happymacer/PF906-treadmill-motor-controller-/pf906 dc motor driver board V3a Dec 22.pdf

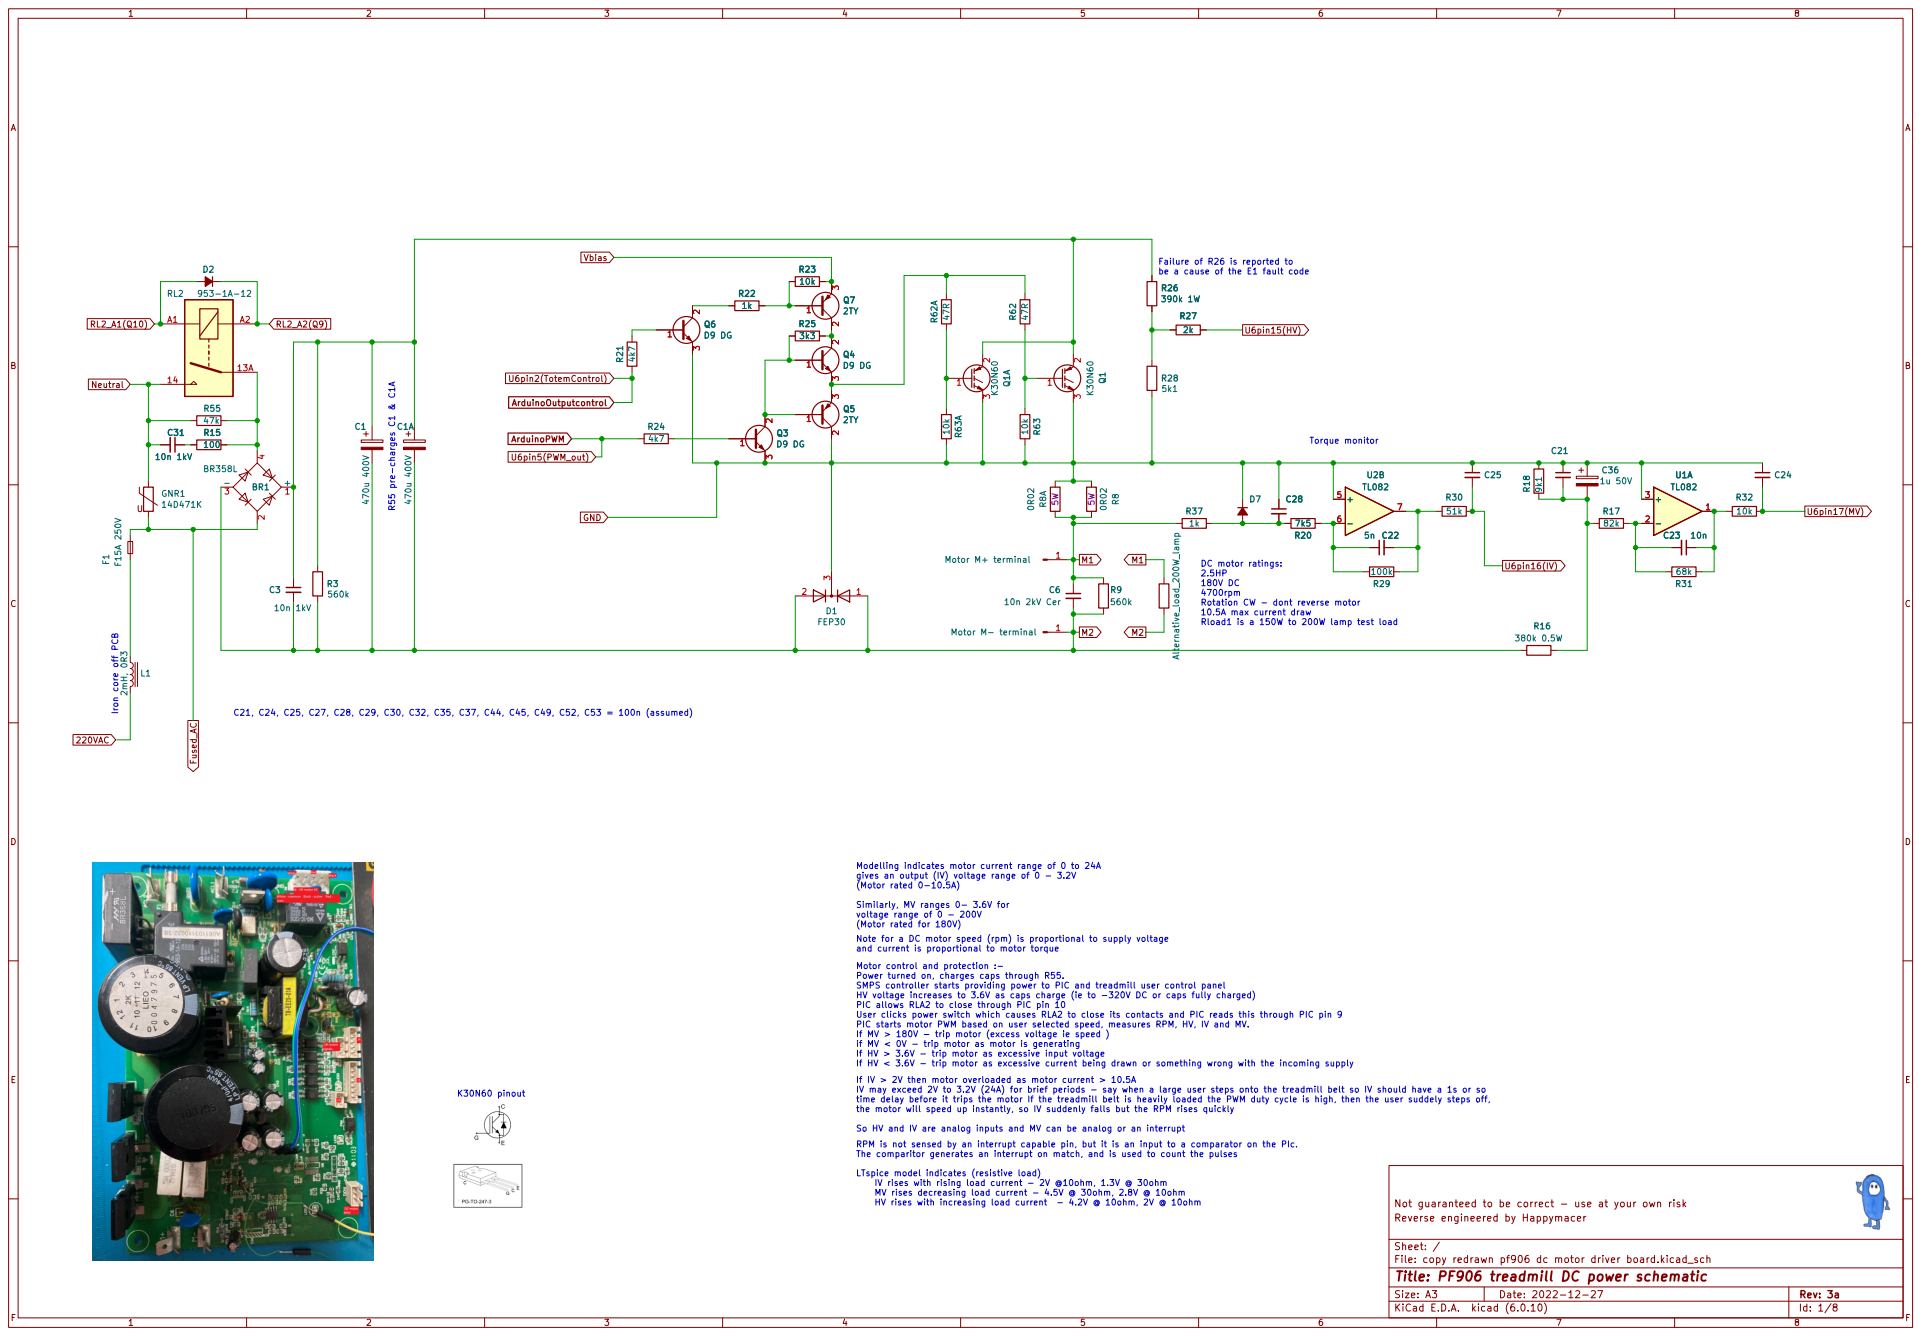
[picture p1: page 1]

If HV < 3.6V - trip motor as excessive current being drawn or something wrong with the incoming supply R55 pre-charges C1 & C1A Iron core off PCB

4700rpm
Rotation CW - dont reverse motor 10.5A max current draw Rload1 is a 150W to 200W lamp test load

Modelling indicates motor current range of 0 to 24A
gives an output (IV) voltage range of 0 - 3.2V
(Motor rated 0-10.5A)

Similarly, MV ranges 0- 3.6V for
voltage range of 0 - 200V
(Motor rated for 180V)
Note for a DC motor speed (rpm) is proportional to supply voltage
and current is proportional to motor torque
Motor control and protection :-
Power turned on, charges caps through R55.
SMPS controller starts providing power to PIC and treadmill user control panel
HV voltage increases to 3.6V as caps charge (ie to -320V DC or caps fully charged)
PIC allows RLA2 to close through PIC pin 10
User clicks power switch which causes RLA2 to close its contacts and PIC reads this through PIC pin 9
PIC starts motor PWM based on user selected speed, measures RPM, HV, IV and MV.
If MV > 180V - trip motor (excess voltage ie speed )
if MV < 0V - trip motor as motor is generating
If HV > 3.6V - trip motor as excessive input voltage

If IV > 2V then motor overloaded as motor current > 10.5A
IV may exceed 2V to 3.2V (24A) for brief periods - say when a large user steps onto the treadmill belt so IV should have a 1s or so
time delay before it trips the motor If the treadmill belt is heavily loaded the PWM duty cycle is high, then the user suddely steps off,
the motor will speed up instantly, so IV suddenly falls but the RPM rises quickly

So HV and IV are analog inputs and MV can be analog or an interrupt
RPM is not sensed by an interrupt capable pin, but it is an input to a comparator on the PIc.
The comparitor generates an interrupt on match, and is used to count the pulses

LTspice model indicates (resistive load)
IV rises with rising load current - 2V @10ohm, 1.3V @ 30ohm
MV rises decreasing load current - 4.5V @ 30ohm, 2.8V @ 10ohm
HV rises with increasing load current - 4.2V @ 10ohm, 2V @ 10ohm

Not guaranteed to be correct - use at your own risk
File: copy redrawn pf906 dc motor driver board.kicad_sch Sheet: / Reverse engineered by Happymacer

Id: 1/8 Title: PF906 treadmill DC power schematic

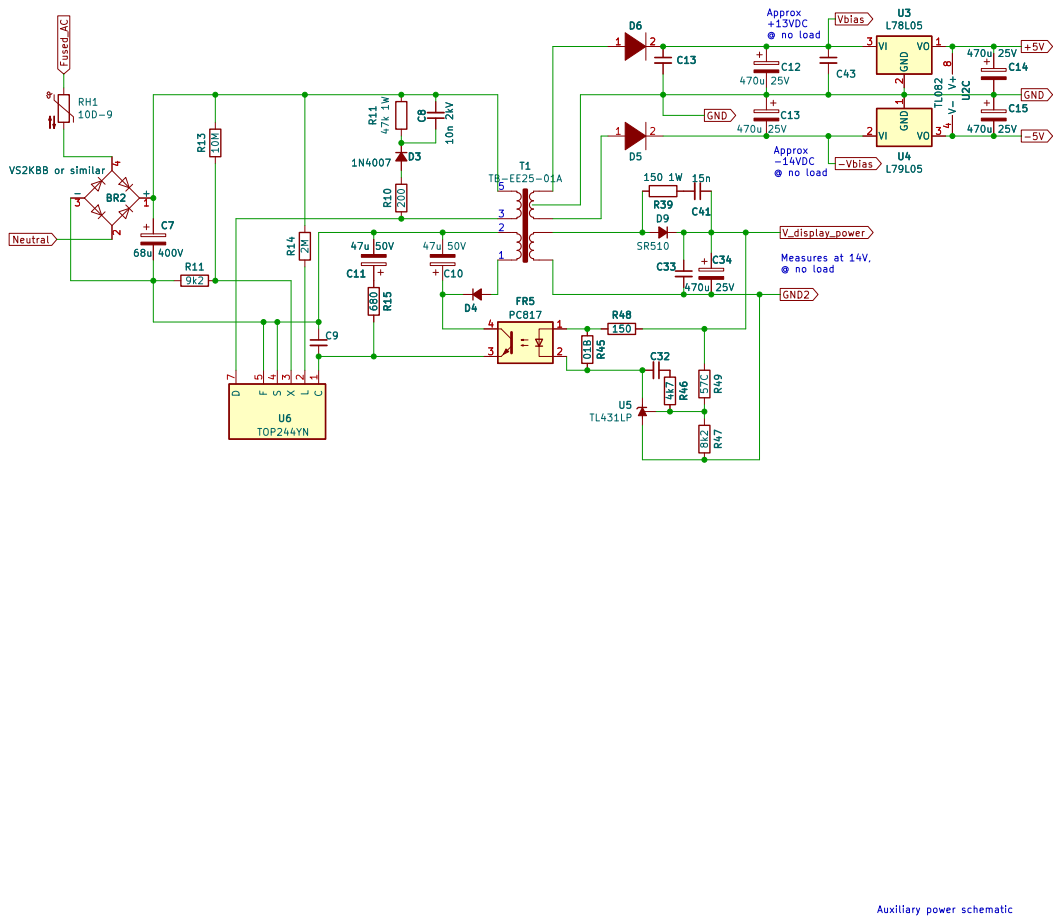
[picture p2: page 2]

Not guaranteed to be correct - use at your own risk
Reverse engineered by Happymacer

Sheet: /2 Aux power/
File: Aux power.kicad_sch
Id: 2/8 Title: PF906 treadmill DC power schematic

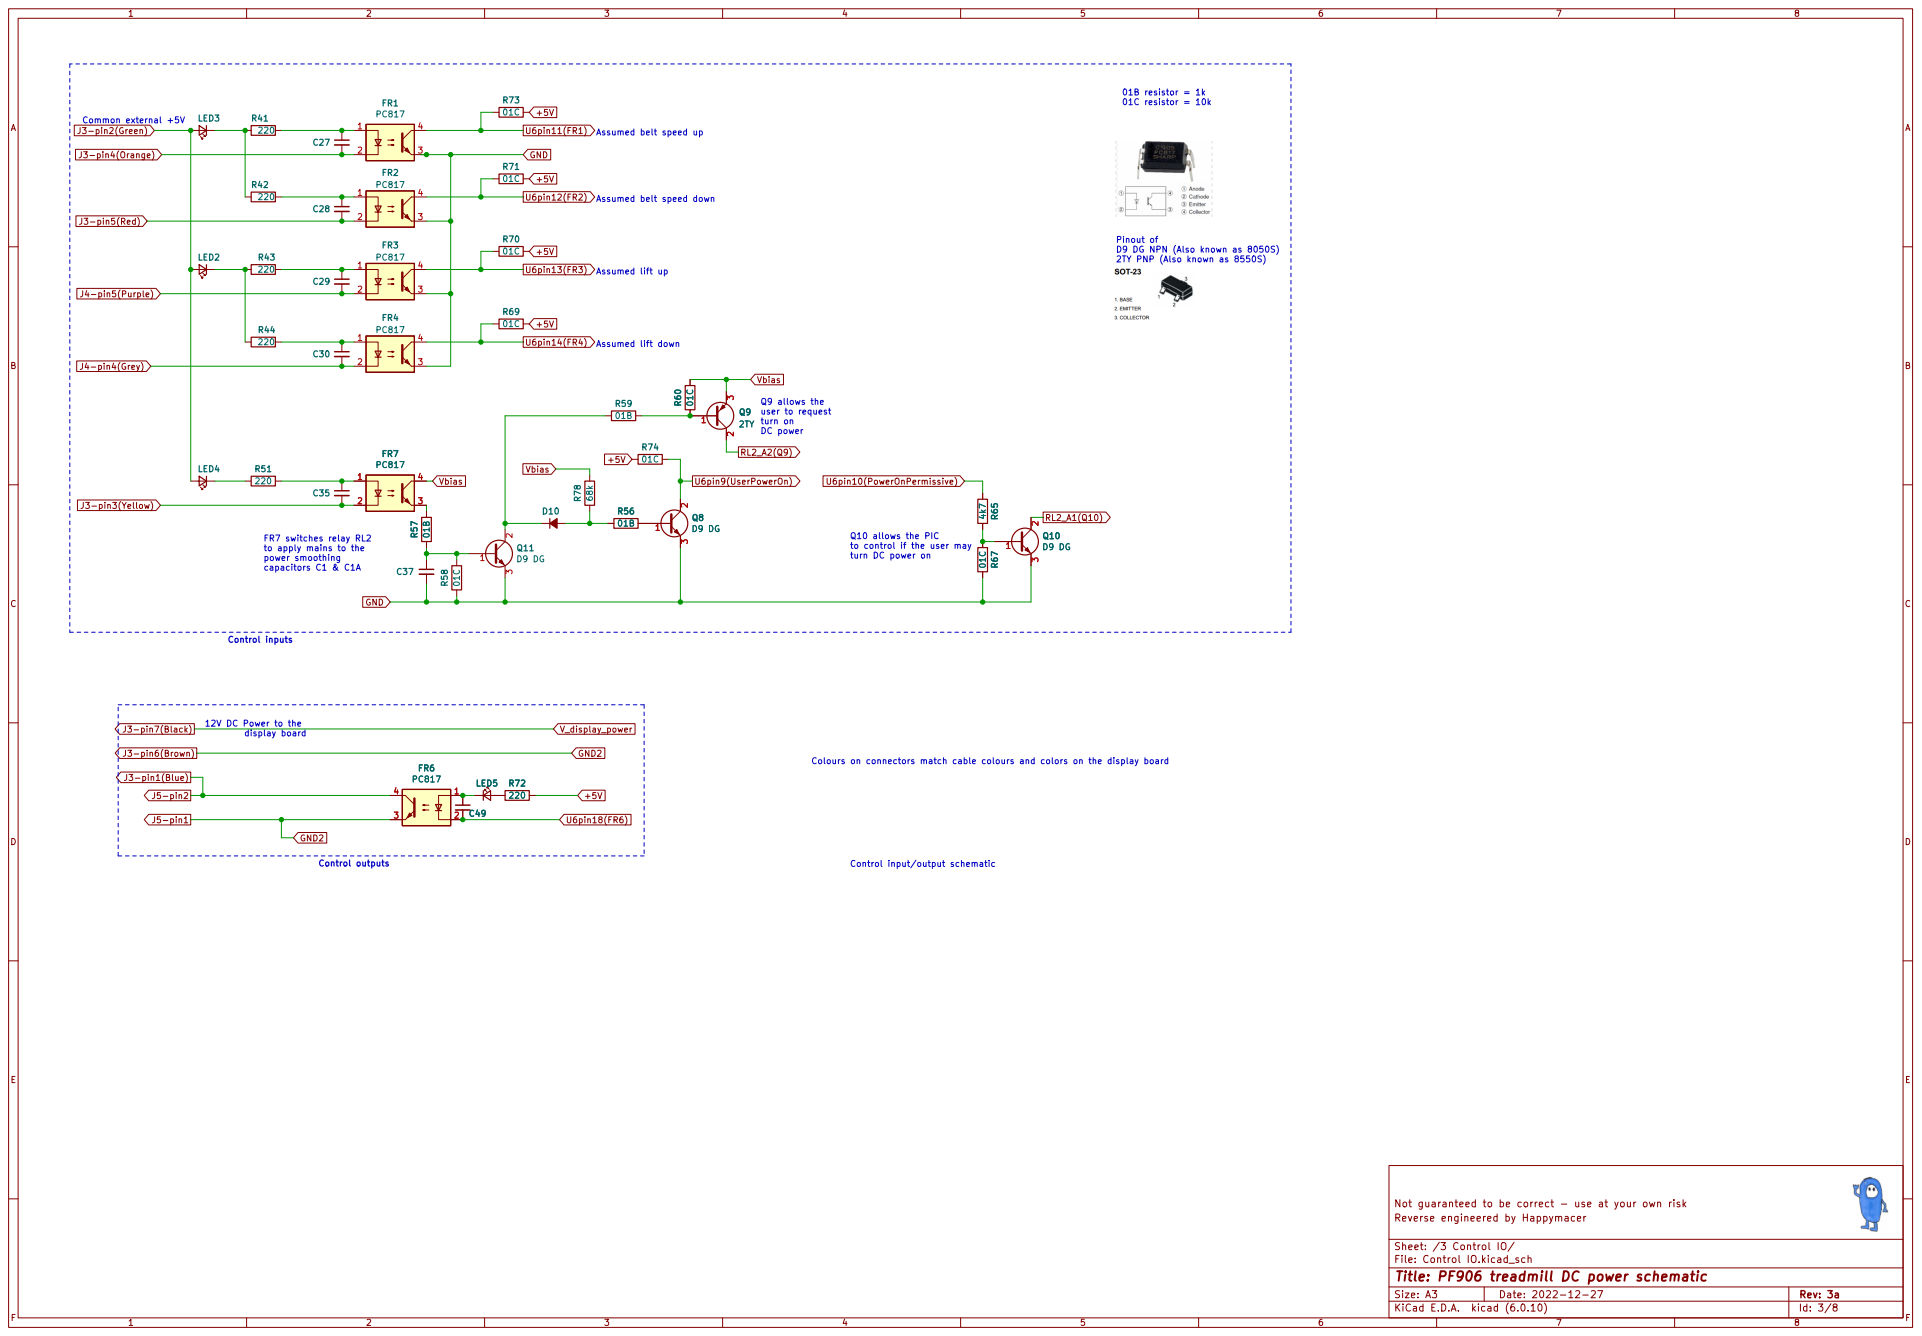
[picture p3: page 3]

01B resistor = 1k 01C resistor = 10k Pinout of D9 DG NPN (Also known as 8050S)

turn on DC power Common external +5V
J3-pin2(Green)

Assumed belt speed down

2TY PNP (Also known as 8550S) Q10 allows the PIC

Assumed lift down Control inputs

FR7 switches relay RL2
to apply mains to the
power smoothing
capacitors C1 & C1A

to control if the user may
turn DC power on

12V DC Power to the display board

Colours on connectors match cable colours and colors on the display board

Control input/output schematic

Not guaranteed to be correct - use at your own risk
File: Control IO.kicad_sch Sheet: /3 Control IO/ Reverse engineered by Happymacer

Id: 3/8 Title: PF906 treadmill DC power schematic

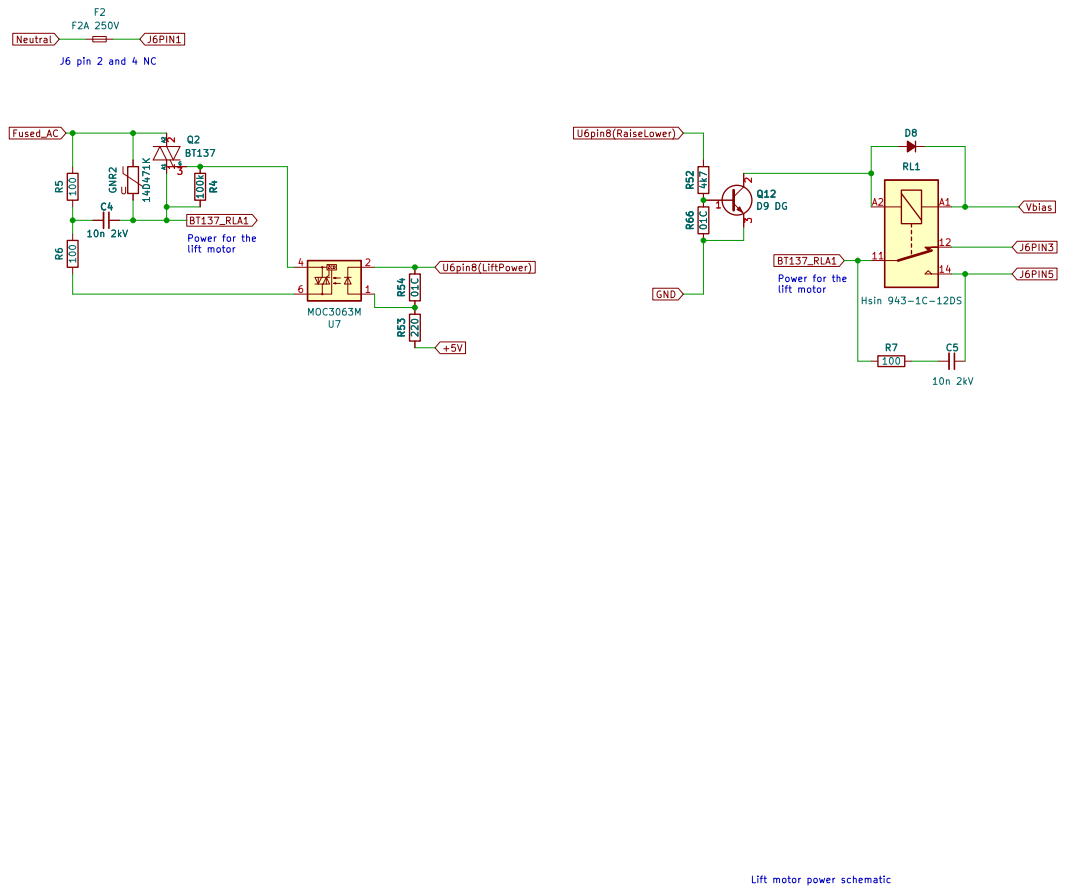
[picture p4: page 4]

Lift motor power schematic

Not guaranteed to be correct - use at your own risk
File: Lift Motor Control.kicad_sch Sheet: /4 Lift Motor Control/ Reverse engineered by Happymacer

Id: 4/8 Title: PF906 treadmill DC power schematic

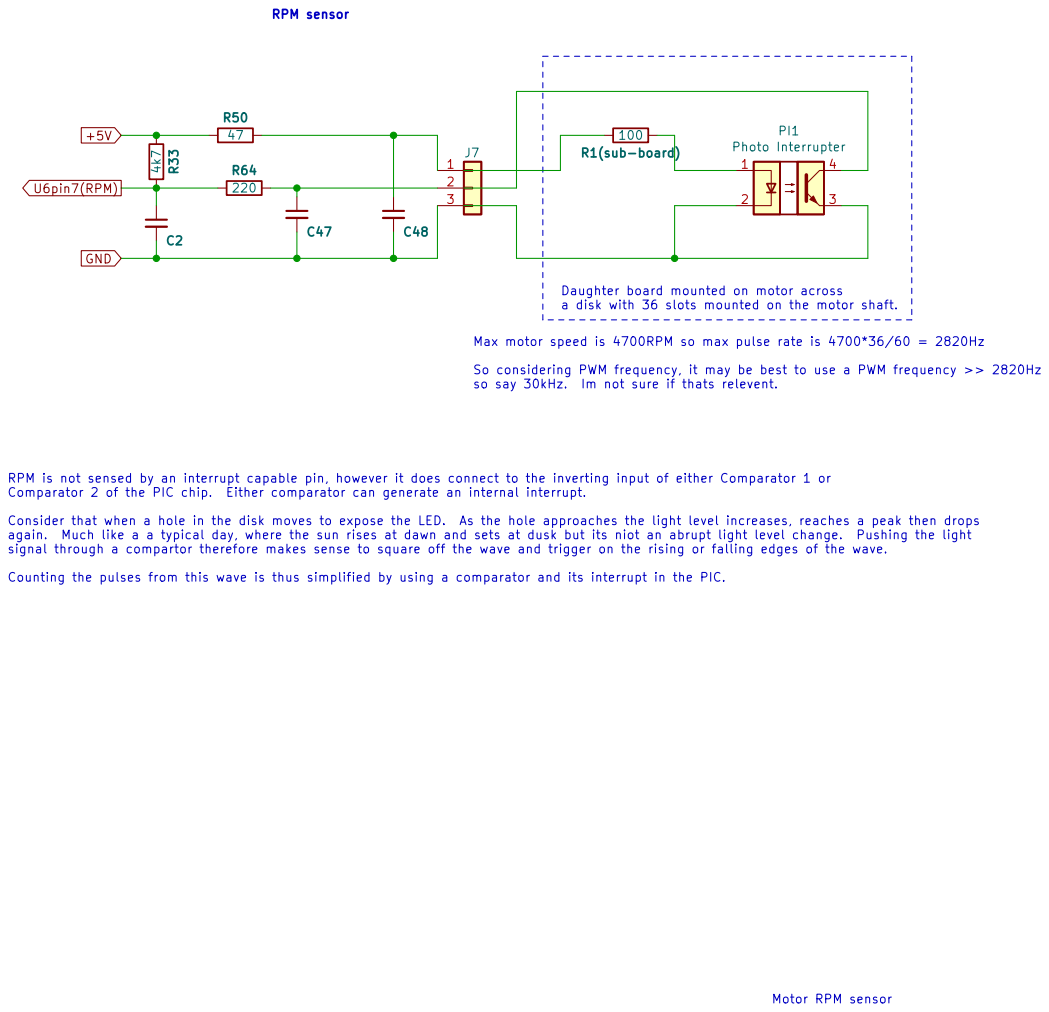
[picture p5: page 5]

So considering PWM frequency, it may be best to use a PWM frequency >> 2820Hz

Comparator 2 of the PIC chip. Either comparator can generate an internal interrupt.

Consider that when a hole in the disk moves to expose the LED. As the hole approaches the light level increases, reaches a peak then drops
again. Much like a a typical day, where the sun rises at dawn and sets at dusk but its niot an abrupt light level change. Pushing the light
signal through a compartor therefore makes sense to square off the wave and trigger on the rising or falling edges of the wave.

Counting the pulses from this wave is thus simplified by using a comparator and its interrupt in the PIC.

File: RPM.kicad_sch Sheet: /5 RPM / Reverse engineered by Happymacer

Id: 5/8 Title: PF906 treadmill DC power schematic

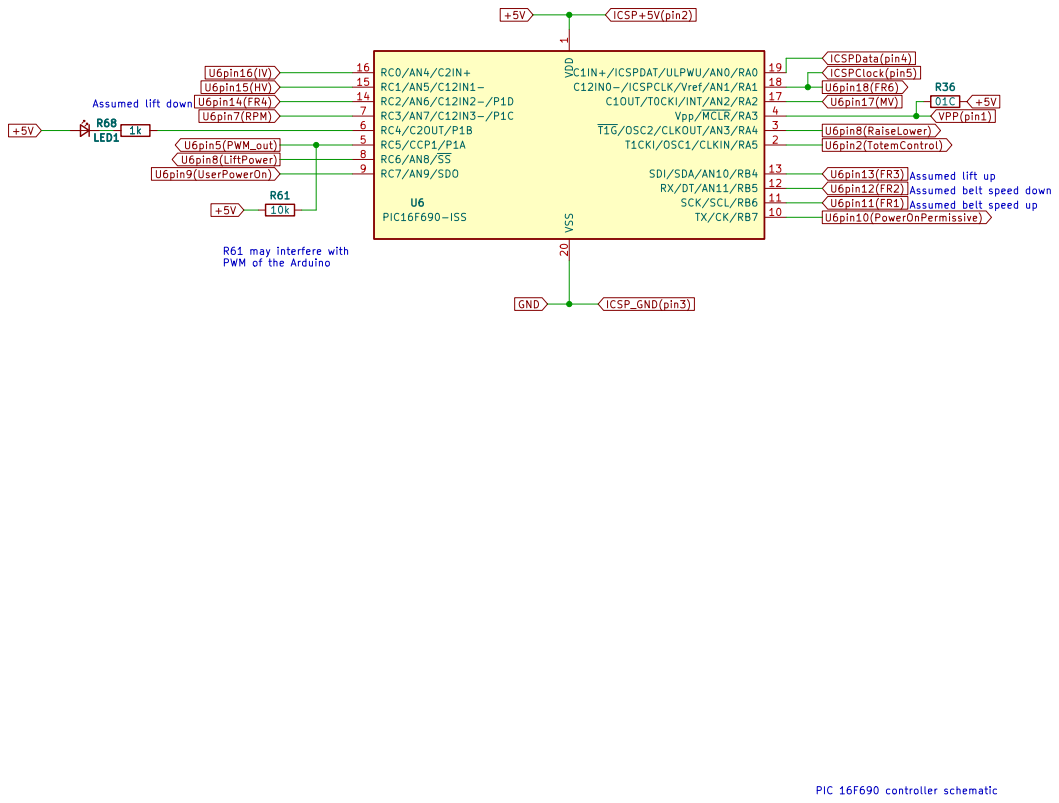
[picture p6: page 6]

Assumed belt speed up PIC 16F690 controller schematic

1 TX/CK/RB7 10 SCK/SCL/RB6 11 RX/DT/AN11/RB5 12 SDI/SDA/AN10/RB4 13 RC2/AN6/C12IN2-/P1D 14 RC1/AN5/C12IN1- 15 RC0/AN4/C2IN+ 16 C1OUT/T0CKI/INT/AN2/RA2 17 C12IN0-/ICSPCLK/Vref/AN1/RA1 18 C1IN+/ICSPDAT/ULPWU/AN0/RA0 19 T1CKI/OSC1/CLKIN/RA5 2 VSS 20

Assumed belt speed down LED1 R68

Not guaranteed to be correct - use at your own risk
File: PIC 16F690 Controller.kicad_sch Sheet: /6 PIC 16F690 Controller/ Reverse engineered by Happymacer

Id: 6/8 Title: PF906 treadmill DC power schematic

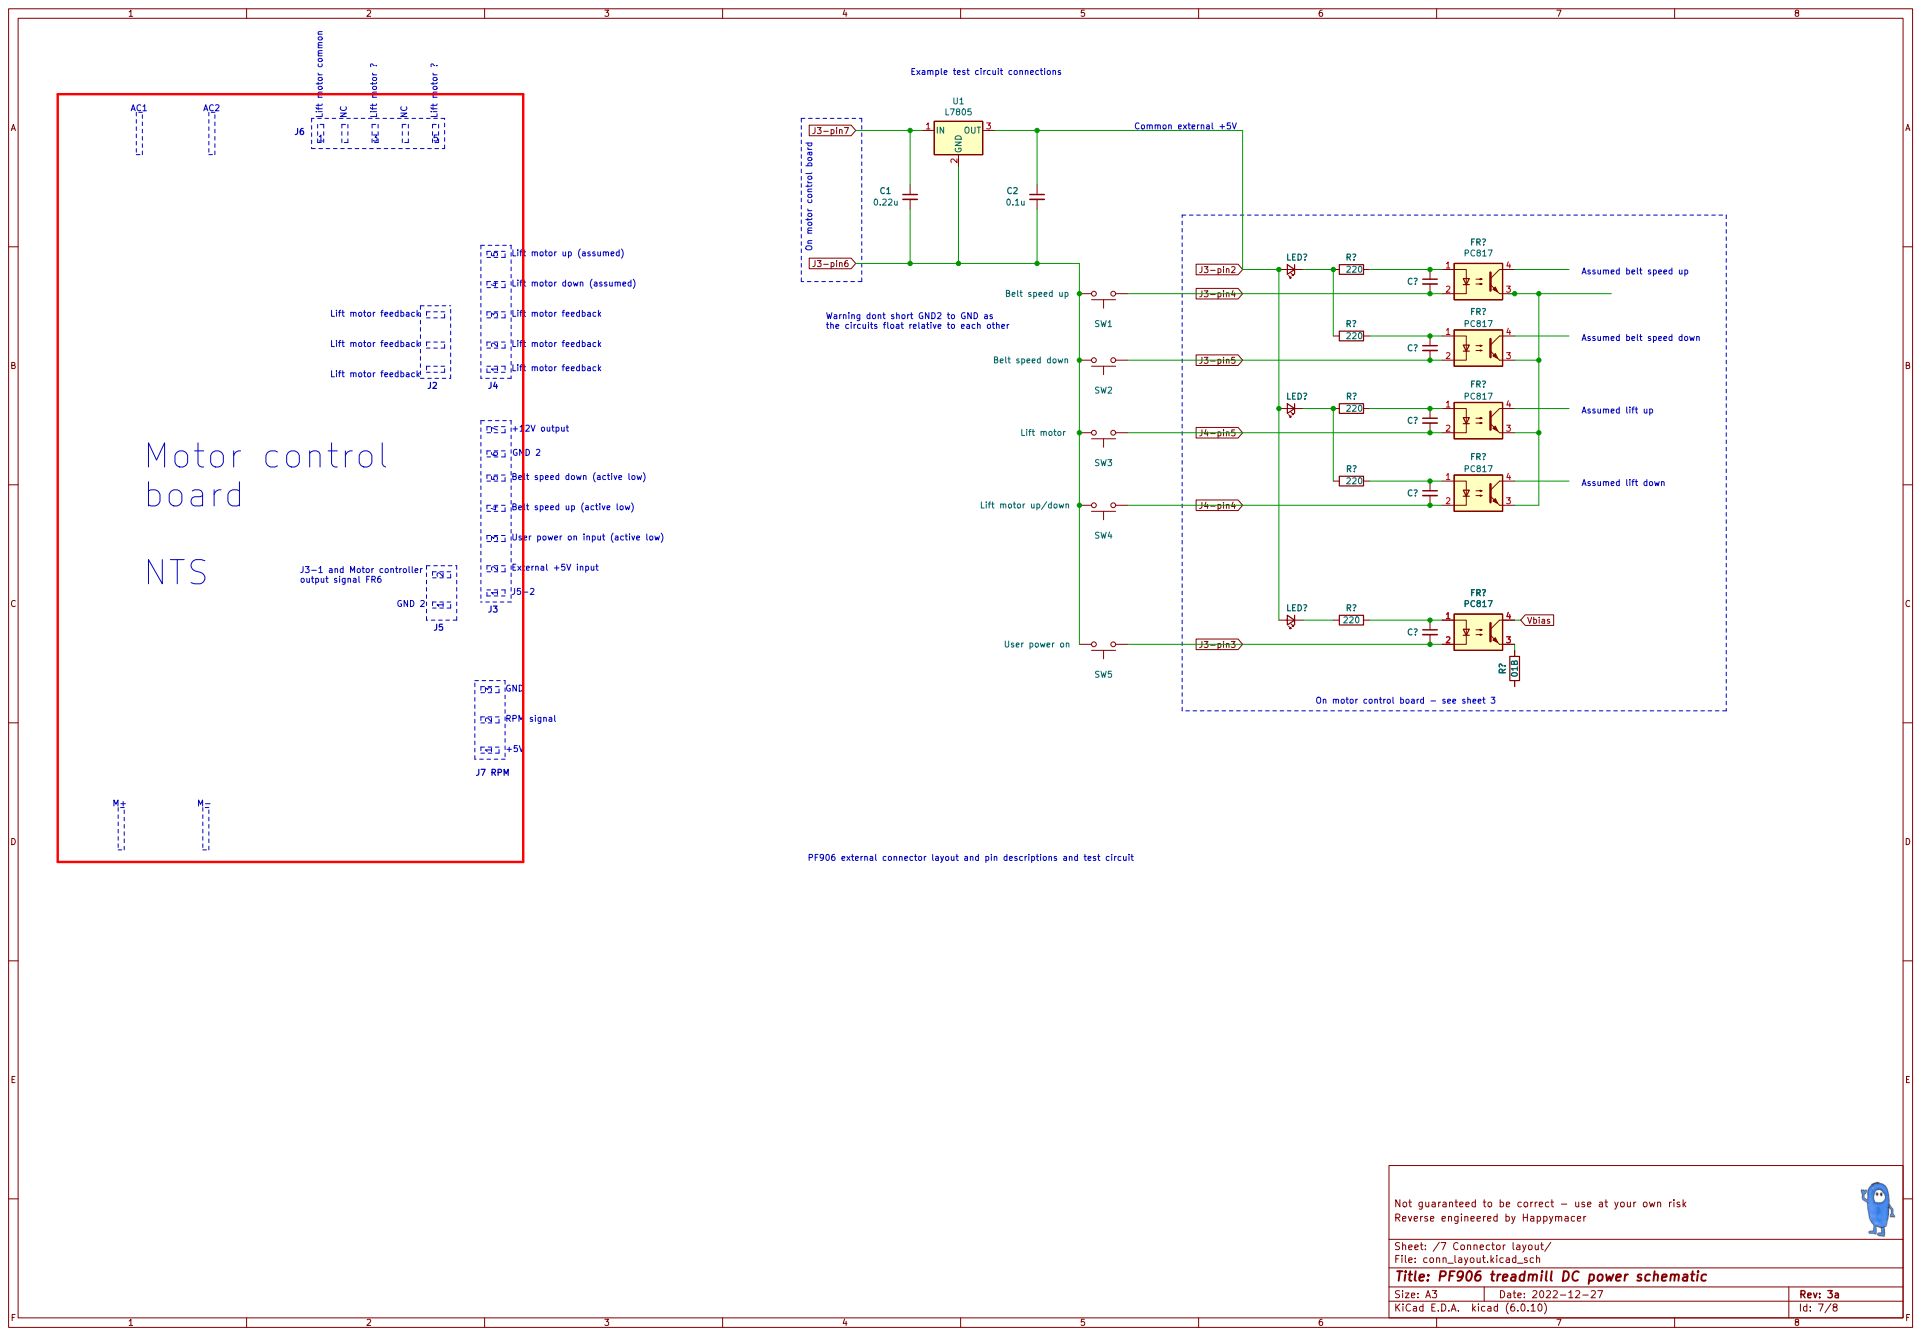
[picture p7: page 7]

Assumed lift up NC

Lift motor up (assumed) 3

Assumed belt speed up

Lift motor feedback Lift motor feedback Lift motor down (assumed)

Lift motor feedback

2 Warning dont short GND2 to GND as

Assumed belt speed down

Lift motor feedback Motor control

Belt speed down (active low) 1

Belt speed up (active low)

Lift motor up/down

User power on input (active low)

J3-1 and Motor controller output signal FR6

Not guaranteed to be correct - use at your own risk
Reverse engineered by Happymacer

Sheet: /7 Connector layout/
File: conn_layout.kicad_sch
Id: 7/8 Title: PF906 treadmill DC power schematic

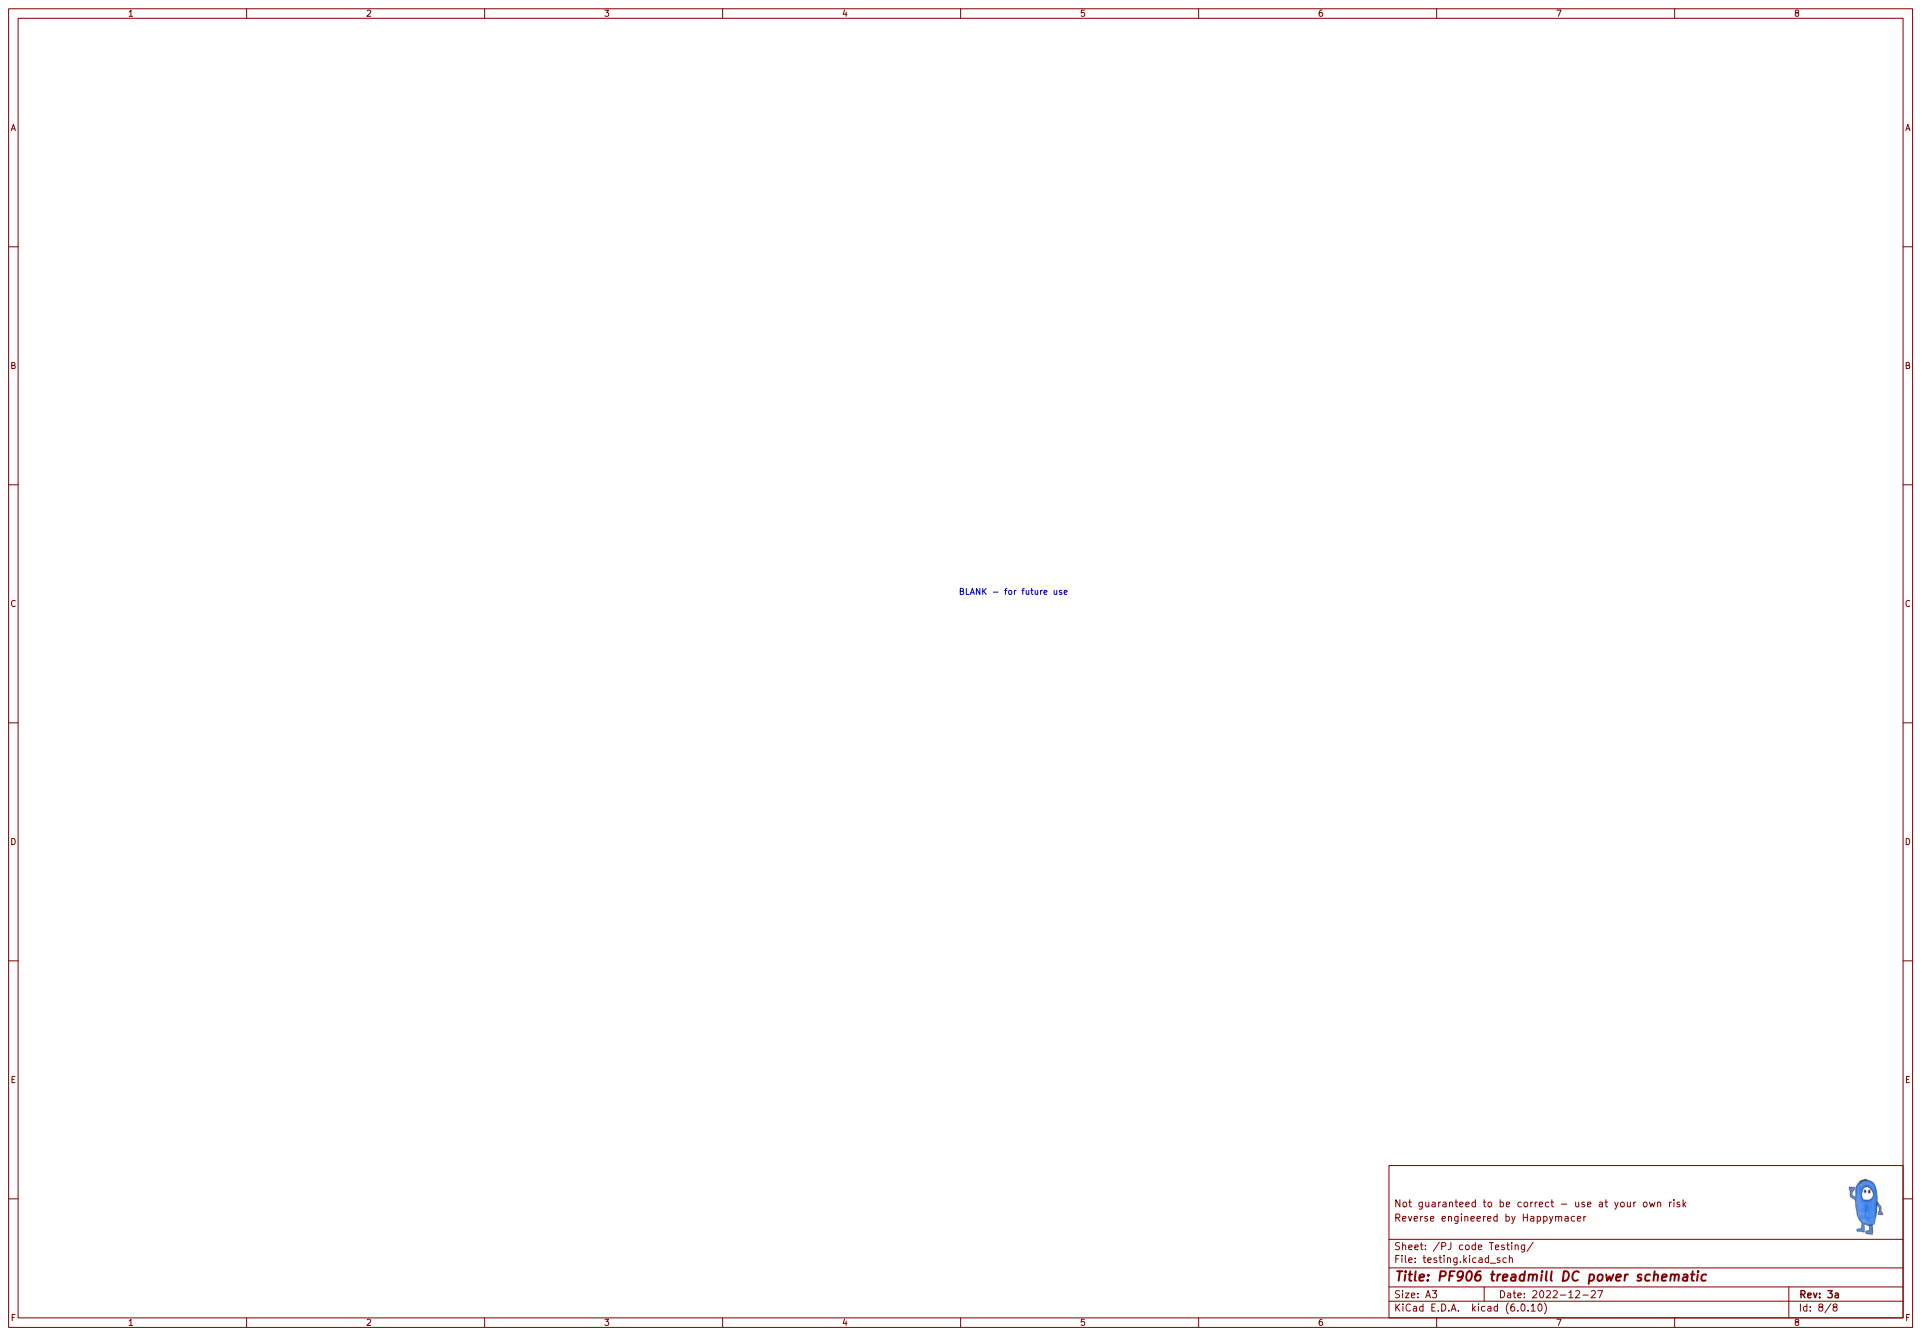
[picture p8: page 8]

BLANK - for future use

Not guaranteed to be correct - use at your own risk
Reverse engineered by Happymacer

Sheet: /PJ code Testing/
File: testing.kicad_sch
Id: 8/8 Title: PF906 treadmill DC power schematic
