happymacer/PF906-treadmill-motor-controller-/Arduino pro-mini pf906 PWM controller.pdf

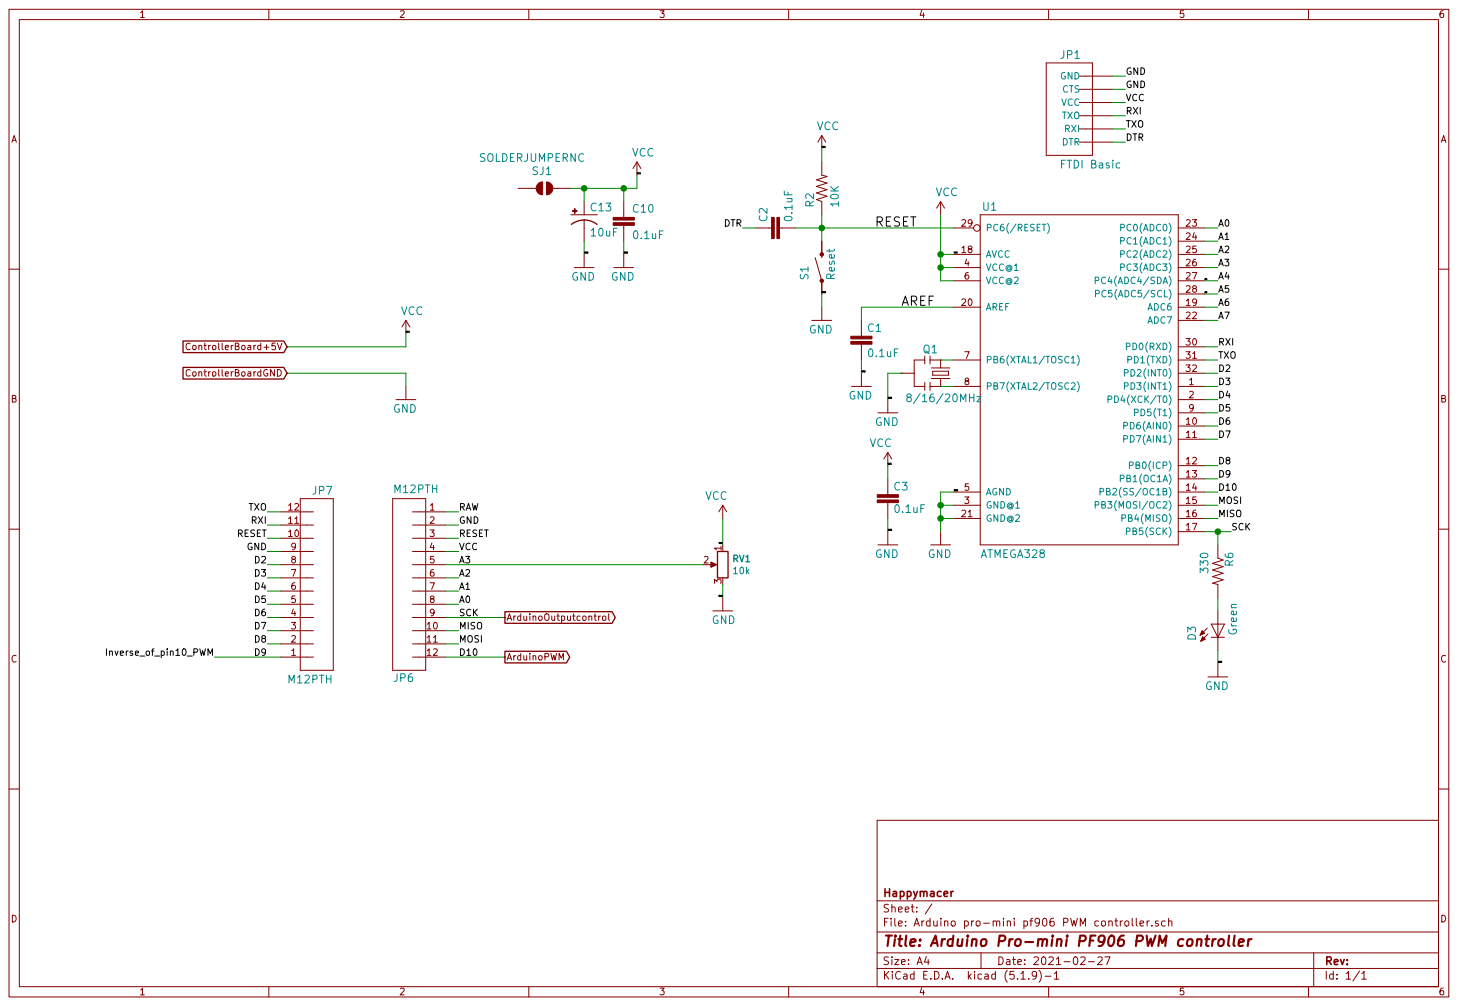
[picture p9: page 1]

Id: 1/1 Title: Arduino Pro-mini PF906 PWM controller
