happymacer/PF906-treadmill-motor-controller-/(threads)

Thread 1 (2022-12-23):

Minor correction of original schematics.

henri62, 2022-12-23:
FYI: (since the original kicad schematic is not published I cannot modify it myself)

Please adjust the schematic:
R26 =390k (and is often the cause of a defect with code E1)
C6 is a non-polar ceramic capactor of 10 n/ 1kV.
R9 = 560 k

J3-pin1 is also connected to J5-pin2, add a label at the left bottom somewhere too.

happymacer, 2022-12-27:
Thanks for the input Henri62.  I have corrected the schematic as follows:
R26 updated to 390k
C6 on my board is 2kV, and as its the "conservative" alternative Ive left it as is.  Added Ceramic and changed symbol to non polarised
R9 is already set at 560k - not sure what you meant.
J3-1 link to J5-2 is already shown on sheet 7 so not added to sheet 1.

I will upload the new schematic file shortly.

henri62, 2022-12-28:
Both R9 and C6 had no value in the schematic. But I see now that the schematic is completely updated into multiple pages and much more detailed.
The schematic I saw (and where the comment was based on) was only 1 page. That is where the confusion comes from.
This issue can be closed.

happymacer, 2022-12-30:
ta, no worries!

Closed 2022-12-30.

Thread 2 (2024-10-16):

Relay part number

kambadur, 2024-10-16:
Appreciate the good work. Have you identified the ac supply side relay part number? If so could you please sahre it.
If not, do you know any same form factor relay for replacement?
Thank you and kind regards,
Sam

happymacer, 2024-10-18:
Thanks Kambadur! Nice to hear!  The supply side relay is a HSINDA953-1A-12DG-1.  Im sure there are many similar relays out there.

kambadur, 2024-10-18:
Thank you too. Couldn't find the exact part. Got a near one `G2RL-1A-E 12DC`. Also from testing found out today that the power stage IGBT was also broken. Ordered the part as well `STGW20NC60VD`
Your work helped a lot with debugging. Thanks again.

Closed 2024-10-16.

Thread 3 (2025-03-16):

Additional info for the schematic.

rev-enge, 2025-03-16:
I just repaired a PF906 board, with the help of your reverse engineered schematics. It was very helpful and saved me a lot of time. So thanks for all the time you spent on it.
I know how much time it costs to do that, I have my own reverse engineering account on github (https://github.com/rev-enge) where I'm going to save all stuff I (partly) reverse engineered (and what is on there now, is only a small part of what I did in the last 30 years). To save it for future generations and to aid other people to repair stuff. Also these are all hobby projects and stuff done in free-time.

I added some remarks in the PF906 schematics about missing component types, so you can do some minor update on the schematic.
The values of D5,D6,C32,R49,R45 are in the attachment marked.
By the way markings such as 01B are EIA-96 encoded values.

[pf906 dc motor driver board V3a Dec 22.pdf](https://github.com/user-attachments/files/19274688/pf906.dc.motor.driver.board.V3a.Dec.22.pdf)

](url)

By the way, the board I repaired (for the second time now) had a broken TL431A (U5)and the symptom is that the power supply start/stops at an intermittent low frequency and the voltage on the +5V drops/comes back. The 14V display power however jumps up to around 40V! Also resulted in a blown up capacitor C34.
