happymacer/PF906-treadmill-motor-controller-/(commit log)

2021-02-01 Add files via upload
    First version of the reverse engineered schematic
2021-02-27 Arduino Pro mini PWM schematic
2021-12-11 Schematic of the screens
    This schematic describes the LCD screens and the PIC hardware mounted on the PF906 treadmill controller board
2022-12-27 see issue 1 - minor schematic errors corrected
2022-12-27 Delete copy redrawn pf906 dc motor driver board.pdf
    replaced with new version 3a
